HimanshiDeSilva/Wireless_Notice_Board/SolidWorks/Screenshot (114).png

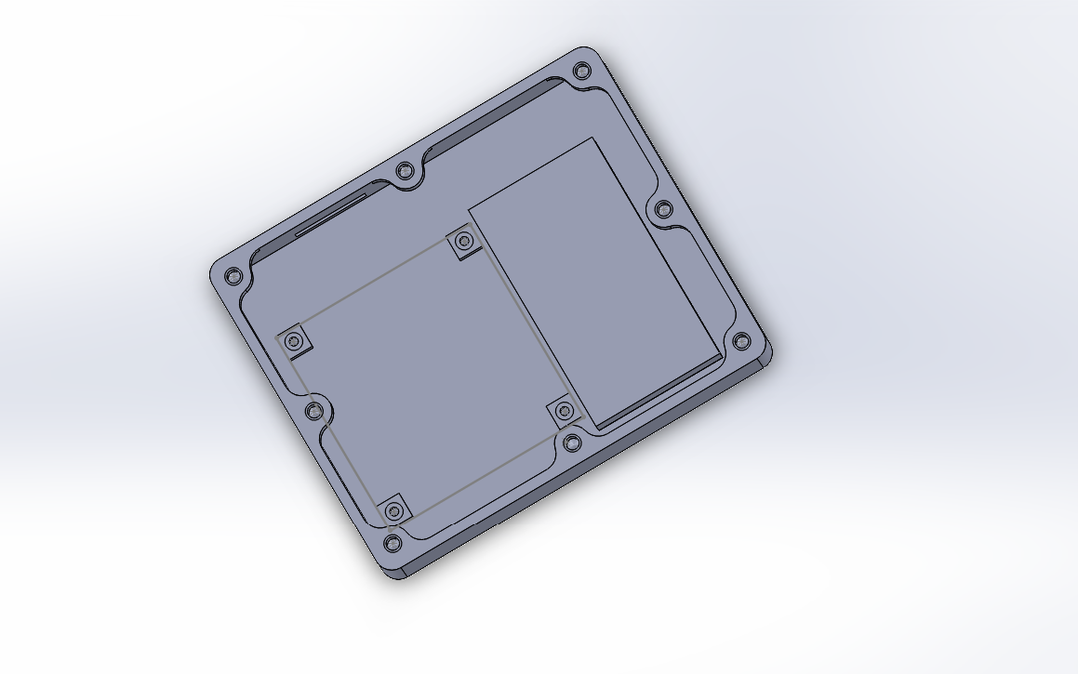
SolidWorks/Screenshot (114).png
