HimanshiDeSilva/Wireless_Notice_Board/SolidWorks/Screenshot (115).png

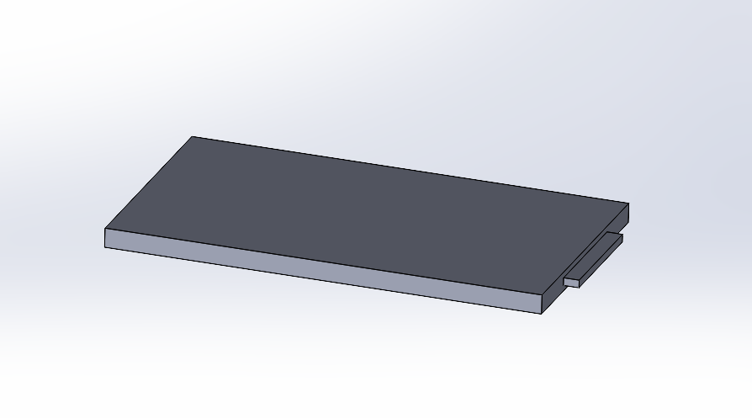
SolidWorks/Screenshot (115).png
