HimanshiDeSilva/Wireless_Notice_Board/SolidWorks/Screenshot (116).png

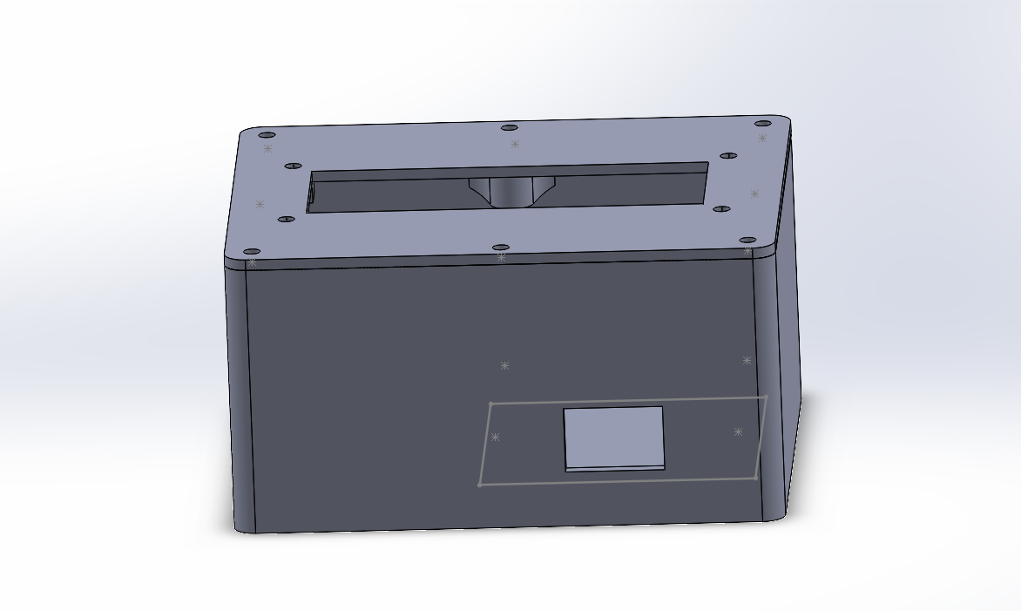
SolidWorks/Screenshot (116).png
