HimanshiDeSilva/Wireless_Notice_Board/SolidWorks/Screenshot (117).png

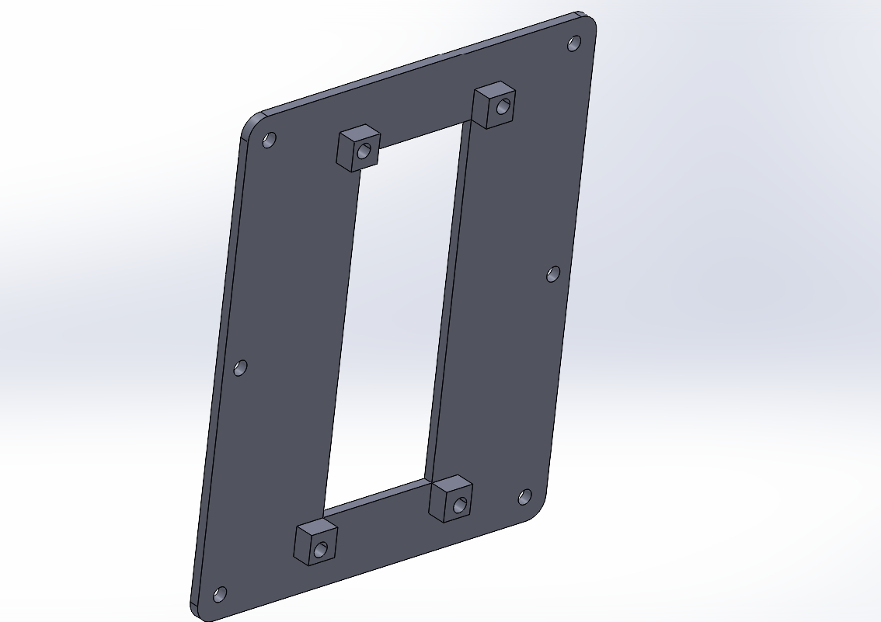
SolidWorks/Screenshot (117).png
