HimanshiDeSilva/Wireless_Notice_Board/SolidWorks/Screenshot (118).png

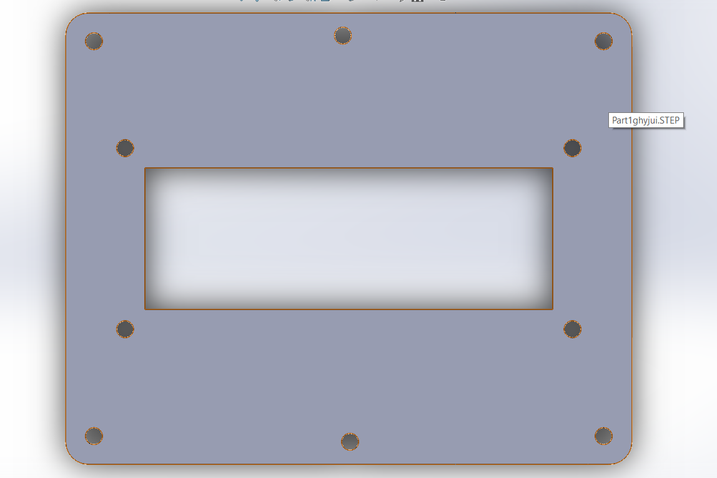
SolidWorks/Screenshot (118).png
