HimanshiDeSilva/Wireless_Notice_Board/SolidWorks/Screenshot (119).png

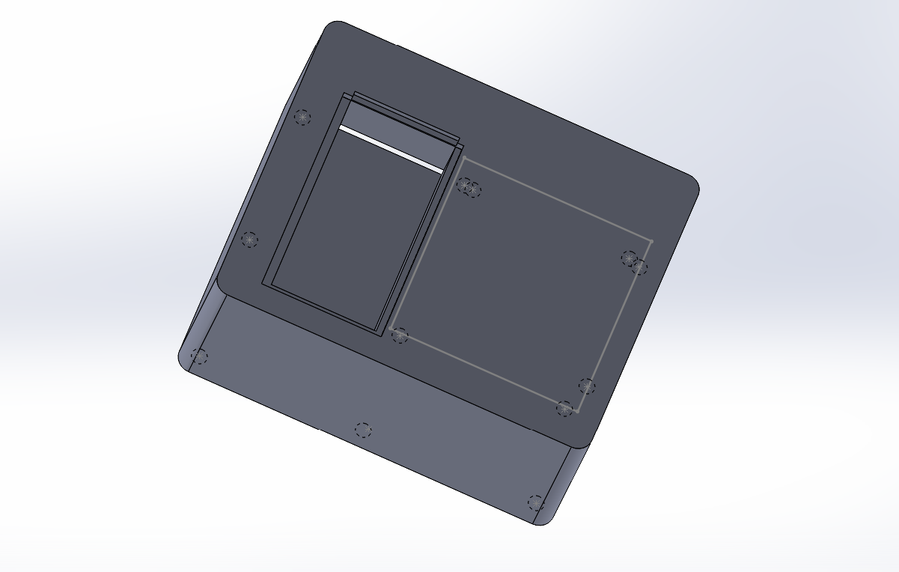
SolidWorks/Screenshot (119).png
