HimanshiDeSilva/Wireless_Notice_Board/SolidWorks/Screenshot (120).png

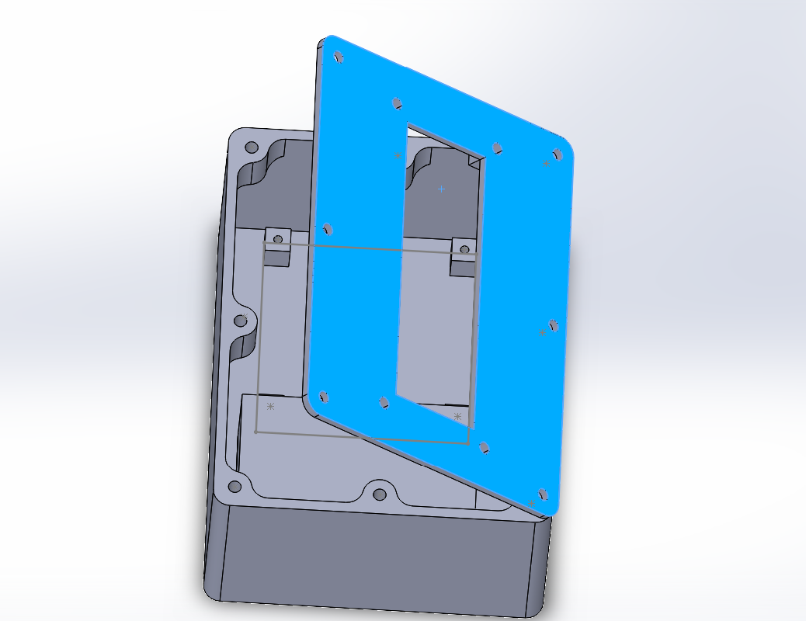
SolidWorks/Screenshot (120).png
