HimanshiDeSilva/Wireless_Notice_Board/SolidWorks/Screenshot (121).png

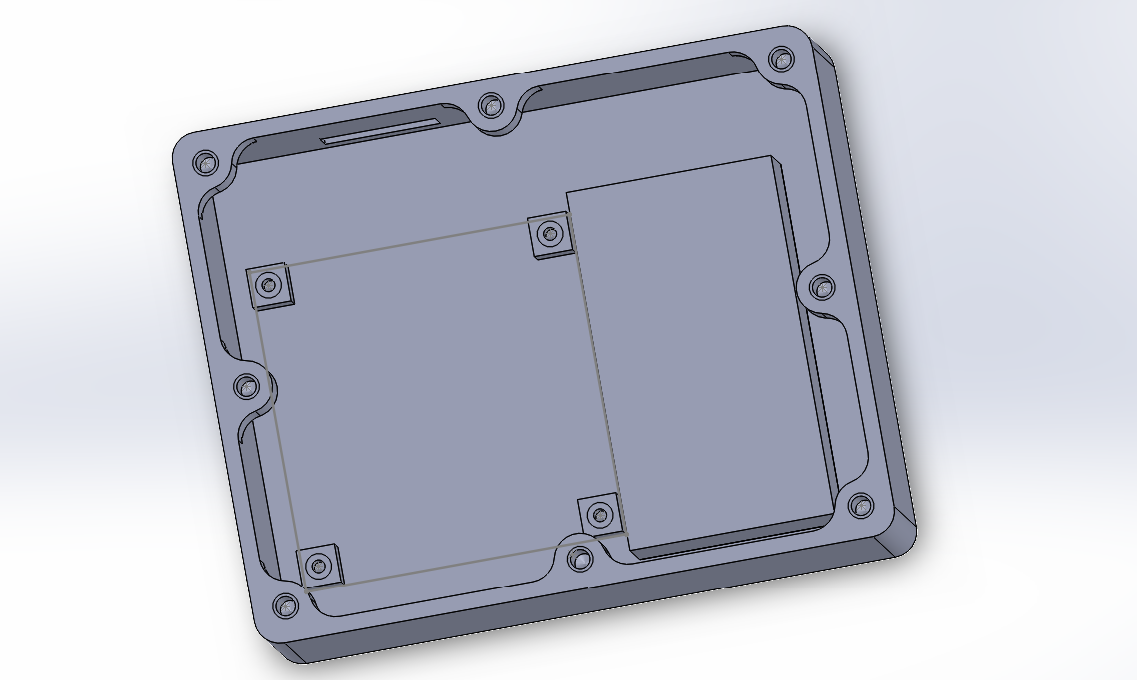
SolidWorks/Screenshot (121).png
