HimanshiDeSilva/Wireless_Notice_Board/SolidWorks/Assem2.SLDASM

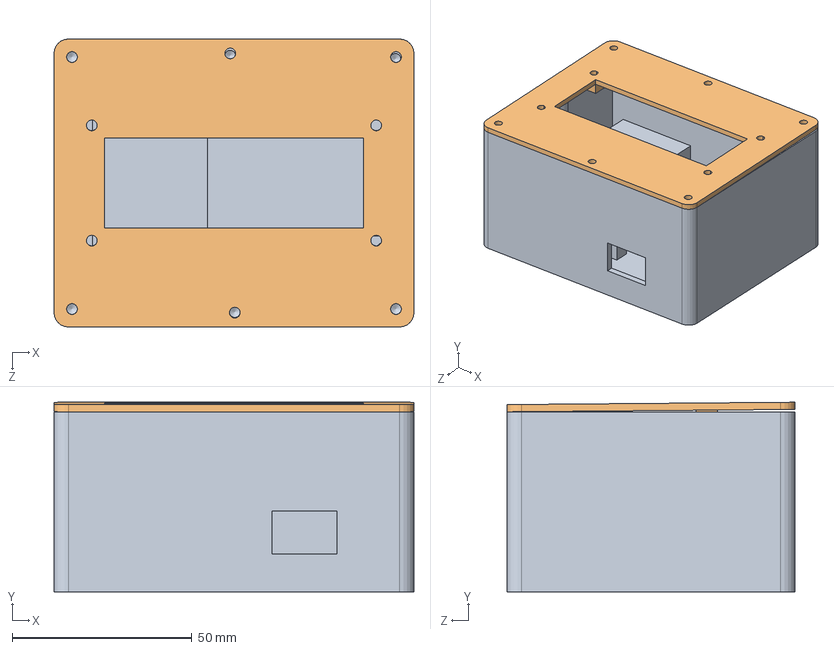
[picture p19: CAD file, 2023-08-15]
SolidWorks/Assem2.SLDASM
100.0 x 52.7 x 80.0 mm
Part01majoir
Part2.1plane
part3batteryplane
