HimanshiDeSilva/Wireless_Notice_Board/SolidWorks/part3batteryplane.SLDPRT

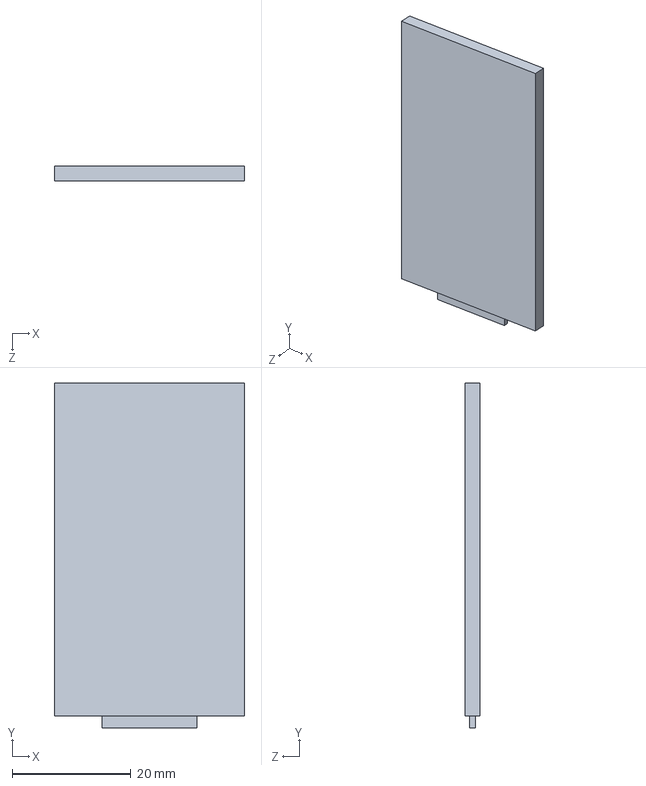
[picture p20: CAD file, 2023-08-15]
SolidWorks/part3batteryplane.SLDPRT
32.0 x 58.0 x 2.50 mm
