HimanshiDeSilva/Wireless_Notice_Board/SolidWorks/Part2.1plane.SLDPRT

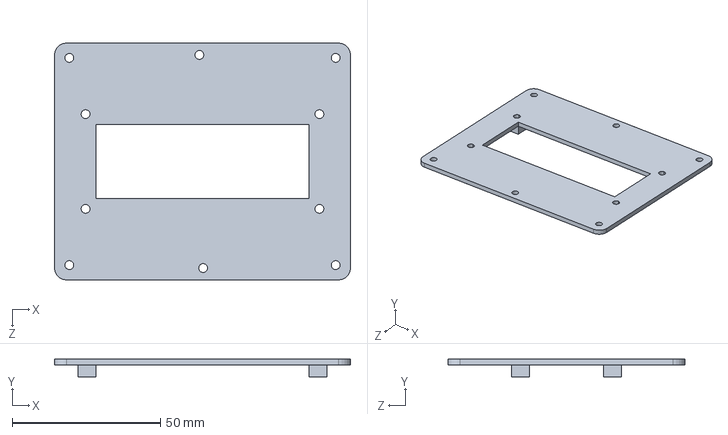
[picture p21: CAD file, 2023-08-15]
SolidWorks/Part2.1plane.SLDPRT
100.0 x 6.00 x 80.0 mm
