HimanshiDeSilva/Wireless_Notice_Board/SolidWorks/Part01majoir.SLDPRT

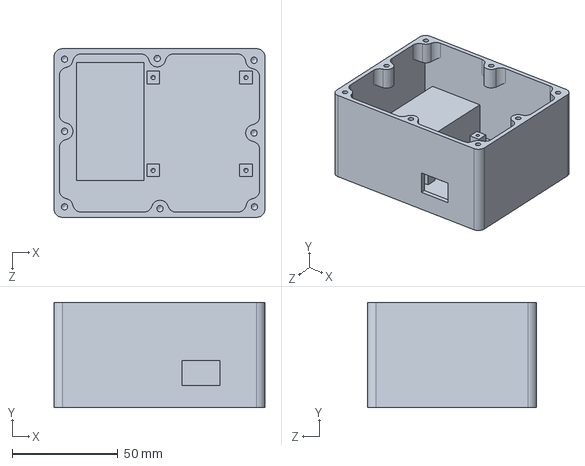
[picture p22: CAD file, 2023-08-15]
SolidWorks/Part01majoir.SLDPRT
100.0 x 50.0 x 80.0 mm
