HimanshiDeSilva/Wireless_Notice_Board/(list of files, drawings)

Other design files:
Altium Files/PCB1.PcbDoc
Altium Files/Sheet1.SchDoc
